Am4l-babu/humidity-controller/(commit log)

2026-09-28 Add HygroPilot: ESP8266 PID humidity controller
    Firmware for an ESP8266 that holds a target humidity with a PID loop,
    including relay-feedback auto-tune, an SSD1306 OLED display, and its own
    Wi-Fi access point serving an interactive dashboard (live control,
    tuning, history analysis, settings). Includes the web UI source with a
    built-in demo simulator, build tooling, and a README with screenshots.
2026-09-28 Use DHT11 on D4 (GPIO2) and disable the on-board LED that shares it
2026-09-28 Add SHT41 support, make it the default sensor, log readings over serial
